philipf/motion-light/README.md

# motion-light

Simple relay switch controlled by a ATtiny85 when motion is detected.  
It has the following features:
- Reset the 'On' window with 20 seconds each time movement is detected.
- Override switch to disable the on/off logic if required.
- If the controller fails for whatever reason the relay will close.

## Special notes
The passive infra red (PIR) and the relay switch depicted in the diagram are assembled modules.
- The PIR module is similar to this http://imall.iteadstudio.com/im120628009.html
- The relay module similar to this https://www.pololu.com/product/2482.  A 5V would have result in a simpler circuit but I only had a 12V in stock.
- The relay switch should be connected in NC (normally closed) mode ensuring that the circuit is closed when the controller fails.

## Circuit diagram
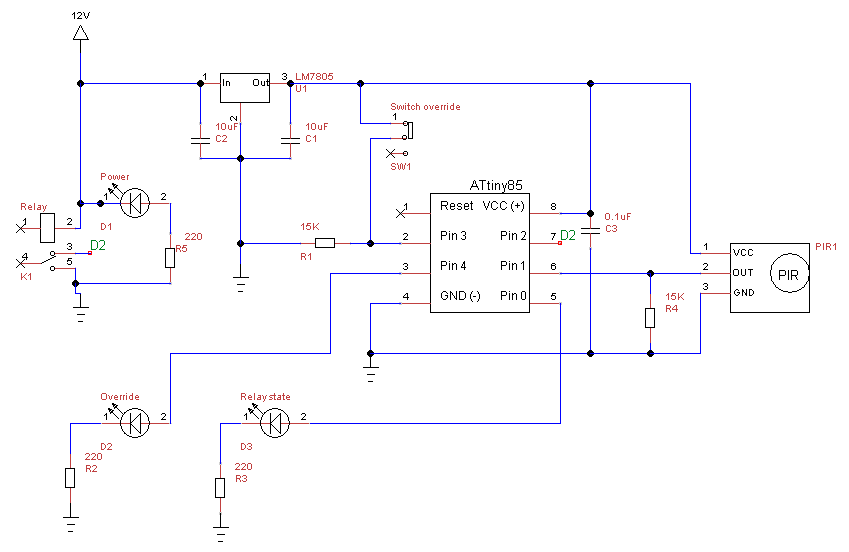
[picture p1: designs/Circuit/Circuit.png]


## Stripboard
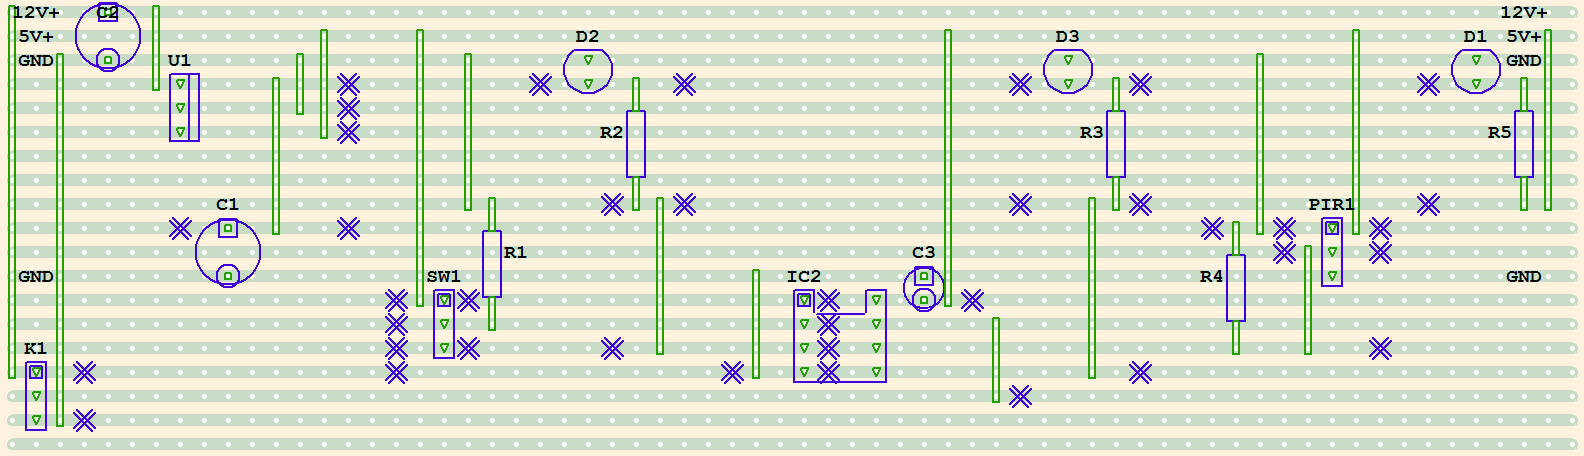
[picture p2: designs/Stripboard/Stripboard.png]


## Photos
Completed project installed in a dark stair case
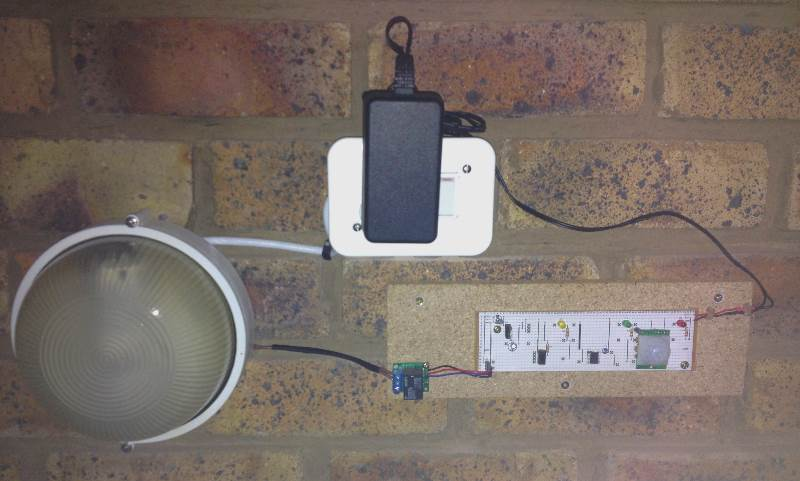
[picture p3: photos/project installed to light.jpg]


Close-up view of the completed project.
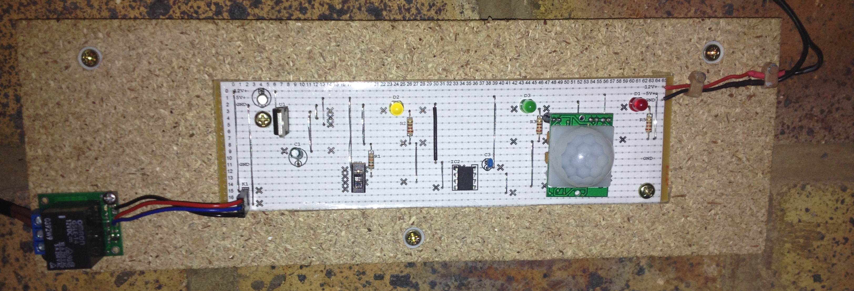
[picture p4: photos/board overview.jpg]
