philipf/motion-light/(list of files, drawings)

Other design files:
designs/Circuit/TinyCadCircuit.dsn
