philipf/motion-light/(commit log)

2015-02-06 Initial commit Basic program structure added. Testing on broadboard, excluding relay and override pin.
    Outstanding issues:
    - Relay integration
    - Pull-down resistors to be added
    - Switch for override
    [motion_light.ino]
2015-02-07 Improvements added to switch off logic. Added ability to override the relay and always keep it open.
2015-02-07 Migrated to AtTiny85
    Added LED indicators for:
    - Power
    - Override (yellow)
    - Relay on (green)
2015-02-07 Switched the working of the relay to opposite to cater for NC (normally closed) of the relay.
    I prefer the NC workings in case I want to bypass this component and still work with the light as before the introduction of this component.
2015-02-07 Designed circuit and strip board from breadboard layout.
    [TinyCadCircuit.dsn]
2015-02-08 Added PNGs with stripboard and circuit designs.
    [TinyCadCircuit.dsn]
2015-02-14 Fixed green LED problem that never switched on.
    Caused by pin mode not set to output.
    [motion_light.ino]
